qandrew/6.115-final-project/Lab Notebook/Pics/5-4d.jpg

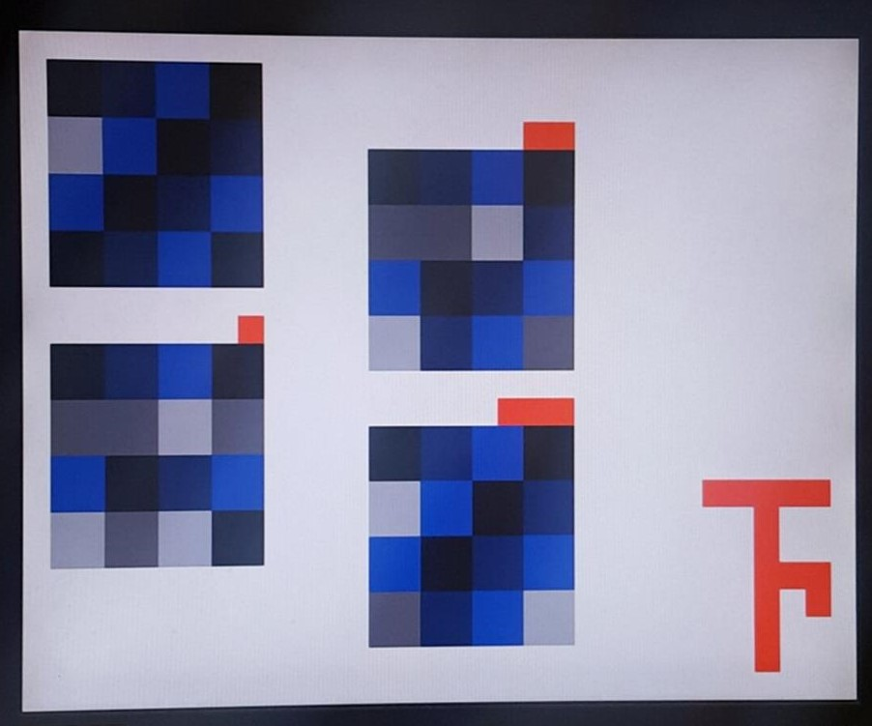
Lab Notebook/Pics/5-4d.jpg
