qandrew/6.115-final-project/Code/VGA/Tic Tac Toe.cydsn/ComponentUpdateLog.txt

Last Modified Date & Time: 04/25/2016 21:32:52

RS232: TopDesign.cysch
	LCD [v1.70] to [v2.20]
	UART [v2.20] to [v2.50]
	RX [v1.70] to [v2.20]
	TX [v1.70] to [v2.20]
	rx_int [v1.60] to [v1.70]
	tx_int [v1.60] to [v1.70]

RS232: RS232.cydwr
	cy_boot [v3.20] to [v5.30]
