qandrew/6.115-final-project/Code/VGA/Tic Tac Toe.cydsn/codegentemp/Pin3.h

/*******************************************************************************
* File Name: Pin3.h  
* Version 2.20
*
* Description:
*  This file contains Pin function prototypes and register defines
*
* Note:
*
********************************************************************************
* Copyright 2008-2015, Cypress Semiconductor Corporation.  All rights reserved.
* You may use this file only in accordance with the license, terms, conditions, 
* disclaimers, and limitations in the end user license agreement accompanying 
* the software package with which this file was provided.
*******************************************************************************/

#if !defined(CY_PINS_Pin3_H) /* Pins Pin3_H */
#define CY_PINS_Pin3_H

#include "cytypes.h"
#include "cyfitter.h"
#include "cypins.h"
#include "Pin3_aliases.h"

/* APIs are not generated for P15[7:6] */
#if !(CY_PSOC5A &&\
	 Pin3__PORT == 15 && ((Pin3__MASK & 0xC0) != 0))


/***************************************
*        Function Prototypes             
***************************************/    

/**
* \addtogroup group_general
* @{
*/
void    Pin3_Write(uint8 value);
void    Pin3_SetDriveMode(uint8 mode);
uint8   Pin3_ReadDataReg(void);
uint8   Pin3_Read(void);
void    Pin3_SetInterruptMode(uint16 position, uint16 mode);
uint8   Pin3_ClearInterrupt(void);
/** @} general */

/***************************************
*           API Constants        
***************************************/
/**
* \addtogroup group_constants
* @{
*/
    /** \addtogroup driveMode Drive mode constants
     * \brief Constants to be passed as "mode" parameter in the Pin3_SetDriveMode() function.
     *  @{
     */
        #define Pin3_DM_ALG_HIZ         PIN_DM_ALG_HIZ
        #define Pin3_DM_DIG_HIZ         PIN_DM_DIG_HIZ
        #define Pin3_DM_RES_UP          PIN_DM_RES_UP
        #define Pin3_DM_RES_DWN         PIN_DM_RES_DWN
        #define Pin3_DM_OD_LO           PIN_DM_OD_LO
        #define Pin3_DM_OD_HI           PIN_DM_OD_HI
        #define Pin3_DM_STRONG          PIN_DM_STRONG
        #define Pin3_DM_RES_UPDWN       PIN_DM_RES_UPDWN
    /** @} driveMode */
/** @} group_constants */
    
/* Digital Port Constants */
#define Pin3_MASK               Pin3__MASK
#define Pin3_SHIFT              Pin3__SHIFT
#define Pin3_WIDTH              8u

/* Interrupt constants */
#if defined(Pin3__INTSTAT)
/**
* \addtogroup group_constants
* @{
*/
    /** \addtogroup intrMode Interrupt constants
     * \brief Constants to be passed as "mode" parameter in Pin3_SetInterruptMode() function.
     *  @{
     */
        #define Pin3_INTR_NONE      (uint16)(0x0000u)
        #define Pin3_INTR_RISING    (uint16)(0x0001u)
        #define Pin3_INTR_FALLING   (uint16)(0x0002u)
        #define Pin3_INTR_BOTH      (uint16)(0x0003u) 
    /** @} intrMode */
/** @} group_constants */

    #define Pin3_INTR_MASK      (0x01u) 
#endif /* (Pin3__INTSTAT) */


/***************************************
*             Registers        
***************************************/

/* Main Port Registers */
/* Pin State */
#define Pin3_PS                     (* (reg8 *) Pin3__PS)
/* Data Register */
#define Pin3_DR                     (* (reg8 *) Pin3__DR)
/* Port Number */
#define Pin3_PRT_NUM                (* (reg8 *) Pin3__PRT) 
/* Connect to Analog Globals */                                                  
#define Pin3_AG                     (* (reg8 *) Pin3__AG)                       
/* Analog MUX bux enable */
#define Pin3_AMUX                   (* (reg8 *) Pin3__AMUX) 
/* Bidirectional Enable */                                                        
#define Pin3_BIE                    (* (reg8 *) Pin3__BIE)
/* Bit-mask for Aliased Register Access */
#define Pin3_BIT_MASK               (* (reg8 *) Pin3__BIT_MASK)
/* Bypass Enable */
#define Pin3_BYP                    (* (reg8 *) Pin3__BYP)
/* Port wide control signals */                                                   
#define Pin3_CTL                    (* (reg8 *) Pin3__CTL)
/* Drive Modes */
#define Pin3_DM0                    (* (reg8 *) Pin3__DM0) 
#define Pin3_DM1                    (* (reg8 *) Pin3__DM1)
#define Pin3_DM2                    (* (reg8 *) Pin3__DM2) 
/* Input Buffer Disable Override */
#define Pin3_INP_DIS                (* (reg8 *) Pin3__INP_DIS)
/* LCD Common or Segment Drive */
#define Pin3_LCD_COM_SEG            (* (reg8 *) Pin3__LCD_COM_SEG)
/* Enable Segment LCD */
#define Pin3_LCD_EN                 (* (reg8 *) Pin3__LCD_EN)
/* Slew Rate Control */
#define Pin3_SLW                    (* (reg8 *) Pin3__SLW)

/* DSI Port Registers */
/* Global DSI Select Register */
#define Pin3_PRTDSI__CAPS_SEL       (* (reg8 *) Pin3__PRTDSI__CAPS_SEL) 
/* Double Sync Enable */
#define Pin3_PRTDSI__DBL_SYNC_IN    (* (reg8 *) Pin3__PRTDSI__DBL_SYNC_IN) 
/* Output Enable Select Drive Strength */
#define Pin3_PRTDSI__OE_SEL0        (* (reg8 *) Pin3__PRTDSI__OE_SEL0) 
#define Pin3_PRTDSI__OE_SEL1        (* (reg8 *) Pin3__PRTDSI__OE_SEL1) 
/* Port Pin Output Select Registers */
#define Pin3_PRTDSI__OUT_SEL0       (* (reg8 *) Pin3__PRTDSI__OUT_SEL0) 
#define Pin3_PRTDSI__OUT_SEL1       (* (reg8 *) Pin3__PRTDSI__OUT_SEL1) 
/* Sync Output Enable Registers */
#define Pin3_PRTDSI__SYNC_OUT       (* (reg8 *) Pin3__PRTDSI__SYNC_OUT) 

/* SIO registers */
#if defined(Pin3__SIO_CFG)
    #define Pin3_SIO_HYST_EN        (* (reg8 *) Pin3__SIO_HYST_EN)
    #define Pin3_SIO_REG_HIFREQ     (* (reg8 *) Pin3__SIO_REG_HIFREQ)
    #define Pin3_SIO_CFG            (* (reg8 *) Pin3__SIO_CFG)
    #define Pin3_SIO_DIFF           (* (reg8 *) Pin3__SIO_DIFF)
#endif /* (Pin3__SIO_CFG) */

/* Interrupt Registers */
#if defined(Pin3__INTSTAT)
    #define Pin3_INTSTAT            (* (reg8 *) Pin3__INTSTAT)
    #define Pin3_SNAP               (* (reg8 *) Pin3__SNAP)
    
	#define Pin3_0_INTTYPE_REG 		(* (reg8 *) Pin3__0__INTTYPE)
	#define Pin3_1_INTTYPE_REG 		(* (reg8 *) Pin3__1__INTTYPE)
	#define Pin3_2_INTTYPE_REG 		(* (reg8 *) Pin3__2__INTTYPE)
	#define Pin3_3_INTTYPE_REG 		(* (reg8 *) Pin3__3__INTTYPE)
	#define Pin3_4_INTTYPE_REG 		(* (reg8 *) Pin3__4__INTTYPE)
	#define Pin3_5_INTTYPE_REG 		(* (reg8 *) Pin3__5__INTTYPE)
	#define Pin3_6_INTTYPE_REG 		(* (reg8 *) Pin3__6__INTTYPE)
	#define Pin3_7_INTTYPE_REG 		(* (reg8 *) Pin3__7__INTTYPE)
#endif /* (Pin3__INTSTAT) */

#endif /* CY_PSOC5A... */

#endif /*  CY_PINS_Pin3_H */


/* [] END OF FILE */
