qandrew/6.115-final-project/Code/VGA/Tic Tac Toe.cydsn/codegentemp/cyfitter.h

#ifndef INCLUDED_CYFITTER_H
#define INCLUDED_CYFITTER_H
#include "cydevice.h"
#include "cydevice_trm.h"

/* RX */
#define RX__0__INTTYPE CYREG_PICU6_INTTYPE0
#define RX__0__MASK 0x01u
#define RX__0__PC CYREG_PRT6_PC0
#define RX__0__PORT 6u
#define RX__0__SHIFT 0
#define RX__AG CYREG_PRT6_AG
#define RX__AMUX CYREG_PRT6_AMUX
#define RX__BIE CYREG_PRT6_BIE
#define RX__BIT_MASK CYREG_PRT6_BIT_MASK
#define RX__BYP CYREG_PRT6_BYP
#define RX__CTL CYREG_PRT6_CTL
#define RX__DM0 CYREG_PRT6_DM0
#define RX__DM1 CYREG_PRT6_DM1
#define RX__DM2 CYREG_PRT6_DM2
#define RX__DR CYREG_PRT6_DR
#define RX__INP_DIS CYREG_PRT6_INP_DIS
#define RX__INTTYPE_BASE CYDEV_PICU_INTTYPE_PICU6_BASE
#define RX__LCD_COM_SEG CYREG_PRT6_LCD_COM_SEG
#define RX__LCD_EN CYREG_PRT6_LCD_EN
#define RX__MASK 0x01u
#define RX__PORT 6u
#define RX__PRT CYREG_PRT6_PRT
#define RX__PRTDSI__CAPS_SEL CYREG_PRT6_CAPS_SEL
#define RX__PRTDSI__DBL_SYNC_IN CYREG_PRT6_DBL_SYNC_IN
#define RX__PRTDSI__OE_SEL0 CYREG_PRT6_OE_SEL0
#define RX__PRTDSI__OE_SEL1 CYREG_PRT6_OE_SEL1
#define RX__PRTDSI__OUT_SEL0 CYREG_PRT6_OUT_SEL0
#define RX__PRTDSI__OUT_SEL1 CYREG_PRT6_OUT_SEL1
#define RX__PRTDSI__SYNC_OUT CYREG_PRT6_SYNC_OUT
#define RX__PS CYREG_PRT6_PS
#define RX__SHIFT 0
#define RX__SLW CYREG_PRT6_SLW

/* TX */
#define TX__0__INTTYPE CYREG_PICU12_INTTYPE6
#define TX__0__MASK 0x40u
#define TX__0__PC CYREG_PRT12_PC6
#define TX__0__PORT 12u
#define TX__0__SHIFT 6
#define TX__AG CYREG_PRT12_AG
#define TX__BIE CYREG_PRT12_BIE
#define TX__BIT_MASK CYREG_PRT12_BIT_MASK
#define TX__BYP CYREG_PRT12_BYP
#define TX__DM0 CYREG_PRT12_DM0
#define TX__DM1 CYREG_PRT12_DM1
#define TX__DM2 CYREG_PRT12_DM2
#define TX__DR CYREG_PRT12_DR
#define TX__INP_DIS CYREG_PRT12_INP_DIS
#define TX__INTTYPE_BASE CYDEV_PICU_INTTYPE_PICU12_BASE
#define TX__MASK 0x40u
#define TX__PORT 12u
#define TX__PRT CYREG_PRT12_PRT
#define TX__PRTDSI__DBL_SYNC_IN CYREG_PRT12_DBL_SYNC_IN
#define TX__PRTDSI__OE_SEL0 CYREG_PRT12_OE_SEL0
#define TX__PRTDSI__OE_SEL1 CYREG_PRT12_OE_SEL1
#define TX__PRTDSI__OUT_SEL0 CYREG_PRT12_OUT_SEL0
#define TX__PRTDSI__OUT_SEL1 CYREG_PRT12_OUT_SEL1
#define TX__PRTDSI__SYNC_OUT CYREG_PRT12_SYNC_OUT
#define TX__PS CYREG_PRT12_PS
#define TX__SHIFT 6
#define TX__SIO_CFG CYREG_PRT12_SIO_CFG
#define TX__SIO_DIFF CYREG_PRT12_SIO_DIFF
#define TX__SIO_HYST_EN CYREG_PRT12_SIO_HYST_EN
#define TX__SIO_REG_HIFREQ CYREG_PRT12_SIO_REG_HIFREQ
#define TX__SLW CYREG_PRT12_SLW

/* LCD_LCDPort */
#define LCD_LCDPort__0__INTTYPE CYREG_PICU2_INTTYPE0
#define LCD_LCDPort__0__MASK 0x01u
#define LCD_LCDPort__0__PC CYREG_PRT2_PC0
#define LCD_LCDPort__0__PORT 2u
#define LCD_LCDPort__0__SHIFT 0
#define LCD_LCDPort__1__INTTYPE CYREG_PICU2_INTTYPE1
#define LCD_LCDPort__1__MASK 0x02u
#define LCD_LCDPort__1__PC CYREG_PRT2_PC1
#define LCD_LCDPort__1__PORT 2u
#define LCD_LCDPort__1__SHIFT 1
#define LCD_LCDPort__2__INTTYPE CYREG_PICU2_INTTYPE2
#define LCD_LCDPort__2__MASK 0x04u
#define LCD_LCDPort__2__PC CYREG_PRT2_PC2
#define LCD_LCDPort__2__PORT 2u
#define LCD_LCDPort__2__SHIFT 2
#define LCD_LCDPort__3__INTTYPE CYREG_PICU2_INTTYPE3
#define LCD_LCDPort__3__MASK 0x08u
#define LCD_LCDPort__3__PC CYREG_PRT2_PC3
#define LCD_LCDPort__3__PORT 2u
#define LCD_LCDPort__3__SHIFT 3
#define LCD_LCDPort__4__INTTYPE CYREG_PICU2_INTTYPE4
#define LCD_LCDPort__4__MASK 0x10u
#define LCD_LCDPort__4__PC CYREG_PRT2_PC4
#define LCD_LCDPort__4__PORT 2u
#define LCD_LCDPort__4__SHIFT 4
#define LCD_LCDPort__5__INTTYPE CYREG_PICU2_INTTYPE5
#define LCD_LCDPort__5__MASK 0x20u
#define LCD_LCDPort__5__PC CYREG_PRT2_PC5
#define LCD_LCDPort__5__PORT 2u
#define LCD_LCDPort__5__SHIFT 5
#define LCD_LCDPort__6__INTTYPE CYREG_PICU2_INTTYPE6
#define LCD_LCDPort__6__MASK 0x40u
#define LCD_LCDPort__6__PC CYREG_PRT2_PC6
#define LCD_LCDPort__6__PORT 2u
#define LCD_LCDPort__6__SHIFT 6
#define LCD_LCDPort__AG CYREG_PRT2_AG
#define LCD_LCDPort__AMUX CYREG_PRT2_AMUX
#define LCD_LCDPort__BIE CYREG_PRT2_BIE
#define LCD_LCDPort__BIT_MASK CYREG_PRT2_BIT_MASK
#define LCD_LCDPort__BYP CYREG_PRT2_BYP
#define LCD_LCDPort__CTL CYREG_PRT2_CTL
#define LCD_LCDPort__DM0 CYREG_PRT2_DM0
#define LCD_LCDPort__DM1 CYREG_PRT2_DM1
#define LCD_LCDPort__DM2 CYREG_PRT2_DM2
#define LCD_LCDPort__DR CYREG_PRT2_DR
#define LCD_LCDPort__INP_DIS CYREG_PRT2_INP_DIS
#define LCD_LCDPort__INTTYPE_BASE CYDEV_PICU_INTTYPE_PICU2_BASE
#define LCD_LCDPort__LCD_COM_SEG CYREG_PRT2_LCD_COM_SEG
#define LCD_LCDPort__LCD_EN CYREG_PRT2_LCD_EN
#define LCD_LCDPort__MASK 0x7Fu
#define LCD_LCDPort__PORT 2u
#define LCD_LCDPort__PRT CYREG_PRT2_PRT
#define LCD_LCDPort__PRTDSI__CAPS_SEL CYREG_PRT2_CAPS_SEL
#define LCD_LCDPort__PRTDSI__DBL_SYNC_IN CYREG_PRT2_DBL_SYNC_IN
#define LCD_LCDPort__PRTDSI__OE_SEL0 CYREG_PRT2_OE_SEL0
#define LCD_LCDPort__PRTDSI__OE_SEL1 CYREG_PRT2_OE_SEL1
#define LCD_LCDPort__PRTDSI__OUT_SEL0 CYREG_PRT2_OUT_SEL0
#define LCD_LCDPort__PRTDSI__OUT_SEL1 CYREG_PRT2_OUT_SEL1
#define LCD_LCDPort__PRTDSI__SYNC_OUT CYREG_PRT2_SYNC_OUT
#define LCD_LCDPort__PS CYREG_PRT2_PS
#define LCD_LCDPort__SHIFT 0
#define LCD_LCDPort__SLW CYREG_PRT2_SLW

/* Pin0 */
#define Pin0__0__INTTYPE CYREG_PICU0_INTTYPE0
#define Pin0__0__MASK 0x01u
#define Pin0__0__PC CYREG_PRT0_PC0
#define Pin0__0__PORT 0u
#define Pin0__0__SHIFT 0
#define Pin0__1__INTTYPE CYREG_PICU0_INTTYPE1
#define Pin0__1__MASK 0x02u
#define Pin0__1__PC CYREG_PRT0_PC1
#define Pin0__1__PORT 0u
#define Pin0__1__SHIFT 1
#define Pin0__2__INTTYPE CYREG_PICU0_INTTYPE2
#define Pin0__2__MASK 0x04u
#define Pin0__2__PC CYREG_PRT0_PC2
#define Pin0__2__PORT 0u
#define Pin0__2__SHIFT 2
#define Pin0__3__INTTYPE CYREG_PICU0_INTTYPE3
#define Pin0__3__MASK 0x08u
#define Pin0__3__PC CYREG_PRT0_PC3
#define Pin0__3__PORT 0u
#define Pin0__3__SHIFT 3
#define Pin0__4__INTTYPE CYREG_PICU0_INTTYPE4
#define Pin0__4__MASK 0x10u
#define Pin0__4__PC CYREG_PRT0_PC4
#define Pin0__4__PORT 0u
#define Pin0__4__SHIFT 4
#define Pin0__5__INTTYPE CYREG_PICU0_INTTYPE5
#define Pin0__5__MASK 0x20u
#define Pin0__5__PC CYREG_PRT0_PC5
#define Pin0__5__PORT 0u
#define Pin0__5__SHIFT 5
#define Pin0__AG CYREG_PRT0_AG
#define Pin0__AMUX CYREG_PRT0_AMUX
#define Pin0__BIE CYREG_PRT0_BIE
#define Pin0__BIT_MASK CYREG_PRT0_BIT_MASK
#define Pin0__BYP CYREG_PRT0_BYP
#define Pin0__CTL CYREG_PRT0_CTL
#define Pin0__DM0 CYREG_PRT0_DM0
#define Pin0__DM1 CYREG_PRT0_DM1
#define Pin0__DM2 CYREG_PRT0_DM2
#define Pin0__DR CYREG_PRT0_DR
#define Pin0__INP_DIS CYREG_PRT0_INP_DIS
#define Pin0__INTTYPE_BASE CYDEV_PICU_INTTYPE_PICU0_BASE
#define Pin0__LCD_COM_SEG CYREG_PRT0_LCD_COM_SEG
#define Pin0__LCD_EN CYREG_PRT0_LCD_EN
#define Pin0__MASK 0x3Fu
#define Pin0__PORT 0u
#define Pin0__PRT CYREG_PRT0_PRT
#define Pin0__PRTDSI__CAPS_SEL CYREG_PRT0_CAPS_SEL
#define Pin0__PRTDSI__DBL_SYNC_IN CYREG_PRT0_DBL_SYNC_IN
#define Pin0__PRTDSI__OE_SEL0 CYREG_PRT0_OE_SEL0
#define Pin0__PRTDSI__OE_SEL1 CYREG_PRT0_OE_SEL1
#define Pin0__PRTDSI__OUT_SEL0 CYREG_PRT0_OUT_SEL0
#define Pin0__PRTDSI__OUT_SEL1 CYREG_PRT0_OUT_SEL1
#define Pin0__PRTDSI__SYNC_OUT CYREG_PRT0_SYNC_OUT
#define Pin0__PS CYREG_PRT0_PS
#define Pin0__SHIFT 0
#define Pin0__SLW CYREG_PRT0_SLW

/* Pin3 */
#define Pin3__0__INTTYPE CYREG_PICU3_INTTYPE0
#define Pin3__0__MASK 0x01u
#define Pin3__0__PC CYREG_PRT3_PC0
#define Pin3__0__PORT 3u
#define Pin3__0__SHIFT 0
#define Pin3__1__INTTYPE CYREG_PICU3_INTTYPE1
#define Pin3__1__MASK 0x02u
#define Pin3__1__PC CYREG_PRT3_PC1
#define Pin3__1__PORT 3u
#define Pin3__1__SHIFT 1
#define Pin3__2__INTTYPE CYREG_PICU3_INTTYPE2
#define Pin3__2__MASK 0x04u
#define Pin3__2__PC CYREG_PRT3_PC2
#define Pin3__2__PORT 3u
#define Pin3__2__SHIFT 2
#define Pin3__3__INTTYPE CYREG_PICU3_INTTYPE3
#define Pin3__3__MASK 0x08u
#define Pin3__3__PC CYREG_PRT3_PC3
#define Pin3__3__PORT 3u
#define Pin3__3__SHIFT 3
#define Pin3__4__INTTYPE CYREG_PICU3_INTTYPE4
#define Pin3__4__MASK 0x10u
#define Pin3__4__PC CYREG_PRT3_PC4
#define Pin3__4__PORT 3u
#define Pin3__4__SHIFT 4
#define Pin3__5__INTTYPE CYREG_PICU3_INTTYPE5
#define Pin3__5__MASK 0x20u
#define Pin3__5__PC CYREG_PRT3_PC5
#define Pin3__5__PORT 3u
#define Pin3__5__SHIFT 5
#define Pin3__6__INTTYPE CYREG_PICU3_INTTYPE6
#define Pin3__6__MASK 0x40u
#define Pin3__6__PC CYREG_PRT3_PC6
#define Pin3__6__PORT 3u
#define Pin3__6__SHIFT 6
#define Pin3__7__INTTYPE CYREG_PICU3_INTTYPE7
#define Pin3__7__MASK 0x80u
#define Pin3__7__PC CYREG_PRT3_PC7
#define Pin3__7__PORT 3u
#define Pin3__7__SHIFT 7
#define Pin3__AG CYREG_PRT3_AG
#define Pin3__AMUX CYREG_PRT3_AMUX
#define Pin3__BIE CYREG_PRT3_BIE
#define Pin3__BIT_MASK CYREG_PRT3_BIT_MASK
#define Pin3__BYP CYREG_PRT3_BYP
#define Pin3__CTL CYREG_PRT3_CTL
#define Pin3__DM0 CYREG_PRT3_DM0
#define Pin3__DM1 CYREG_PRT3_DM1
#define Pin3__DM2 CYREG_PRT3_DM2
#define Pin3__DR CYREG_PRT3_DR
#define Pin3__INP_DIS CYREG_PRT3_INP_DIS
#define Pin3__INTTYPE_BASE CYDEV_PICU_INTTYPE_PICU3_BASE
#define Pin3__LCD_COM_SEG CYREG_PRT3_LCD_COM_SEG
#define Pin3__LCD_EN CYREG_PRT3_LCD_EN
#define Pin3__MASK 0xFFu
#define Pin3__PORT 3u
#define Pin3__PRT CYREG_PRT3_PRT
#define Pin3__PRTDSI__CAPS_SEL CYREG_PRT3_CAPS_SEL
#define Pin3__PRTDSI__DBL_SYNC_IN CYREG_PRT3_DBL_SYNC_IN
#define Pin3__PRTDSI__OE_SEL0 CYREG_PRT3_OE_SEL0
#define Pin3__PRTDSI__OE_SEL1 CYREG_PRT3_OE_SEL1
#define Pin3__PRTDSI__OUT_SEL0 CYREG_PRT3_OUT_SEL0
#define Pin3__PRTDSI__OUT_SEL1 CYREG_PRT3_OUT_SEL1
#define Pin3__PRTDSI__SYNC_OUT CYREG_PRT3_SYNC_OUT
#define Pin3__PS CYREG_PRT3_PS
#define Pin3__SHIFT 0
#define Pin3__SLW CYREG_PRT3_SLW

/* UART_BUART */
#define UART_BUART_sRX_RxBitCounter__16BIT_CONTROL_AUX_CTL_REG CYREG_B0_UDB12_13_ACTL
#define UART_BUART_sRX_RxBitCounter__16BIT_CONTROL_CONTROL_REG CYREG_B0_UDB12_13_CTL
#define UART_BUART_sRX_RxBitCounter__16BIT_CONTROL_COUNT_REG CYREG_B0_UDB12_13_CTL
#define UART_BUART_sRX_RxBitCounter__16BIT_COUNT_CONTROL_REG CYREG_B0_UDB12_13_CTL
#define UART_BUART_sRX_RxBitCounter__16BIT_COUNT_COUNT_REG CYREG_B0_UDB12_13_CTL
#define UART_BUART_sRX_RxBitCounter__16BIT_MASK_MASK_REG CYREG_B0_UDB12_13_MSK
#define UART_BUART_sRX_RxBitCounter__16BIT_MASK_PERIOD_REG CYREG_B0_UDB12_13_MSK
#define UART_BUART_sRX_RxBitCounter__16BIT_PERIOD_MASK_REG CYREG_B0_UDB12_13_MSK
#define UART_BUART_sRX_RxBitCounter__16BIT_PERIOD_PERIOD_REG CYREG_B0_UDB12_13_MSK
#define UART_BUART_sRX_RxBitCounter__CONTROL_AUX_CTL_REG CYREG_B0_UDB12_ACTL
#define UART_BUART_sRX_RxBitCounter__CONTROL_REG CYREG_B0_UDB12_CTL
#define UART_BUART_sRX_RxBitCounter__CONTROL_ST_REG CYREG_B0_UDB12_ST_CTL
#define UART_BUART_sRX_RxBitCounter__COUNT_REG CYREG_B0_UDB12_CTL
#define UART_BUART_sRX_RxBitCounter__COUNT_ST_REG CYREG_B0_UDB12_ST_CTL
#define UART_BUART_sRX_RxBitCounter__MASK_CTL_AUX_CTL_REG CYREG_B0_UDB12_MSK_ACTL
#define UART_BUART_sRX_RxBitCounter__PER_CTL_AUX_CTL_REG CYREG_B0_UDB12_MSK_ACTL
#define UART_BUART_sRX_RxBitCounter__PERIOD_REG CYREG_B0_UDB12_MSK
#define UART_BUART_sRX_RxBitCounter_ST__16BIT_STATUS_AUX_CTL_REG CYREG_B0_UDB12_13_ACTL
#define UART_BUART_sRX_RxBitCounter_ST__16BIT_STATUS_REG CYREG_B0_UDB12_13_ST
#define UART_BUART_sRX_RxBitCounter_ST__MASK_REG CYREG_B0_UDB12_MSK
#define UART_BUART_sRX_RxBitCounter_ST__MASK_ST_AUX_CTL_REG CYREG_B0_UDB12_MSK_ACTL
#define UART_BUART_sRX_RxBitCounter_ST__PER_ST_AUX_CTL_REG CYREG_B0_UDB12_MSK_ACTL
#define UART_BUART_sRX_RxBitCounter_ST__STATUS_AUX_CTL_REG CYREG_B0_UDB12_ACTL
#define UART_BUART_sRX_RxBitCounter_ST__STATUS_CNT_REG CYREG_B0_UDB12_ST_CTL
#define UART_BUART_sRX_RxBitCounter_ST__STATUS_CONTROL_REG CYREG_B0_UDB12_ST_CTL
#define UART_BUART_sRX_RxBitCounter_ST__STATUS_REG CYREG_B0_UDB12_ST
#define UART_BUART_sRX_RxShifter_u0__16BIT_A0_REG CYREG_B0_UDB12_13_A0
#define UART_BUART_sRX_RxShifter_u0__16BIT_A1_REG CYREG_B0_UDB12_13_A1
#define UART_BUART_sRX_RxShifter_u0__16BIT_D0_REG CYREG_B0_UDB12_13_D0
#define UART_BUART_sRX_RxShifter_u0__16BIT_D1_REG CYREG_B0_UDB12_13_D1
#define UART_BUART_sRX_RxShifter_u0__16BIT_DP_AUX_CTL_REG CYREG_B0_UDB12_13_ACTL
#define UART_BUART_sRX_RxShifter_u0__16BIT_F0_REG CYREG_B0_UDB12_13_F0
#define UART_BUART_sRX_RxShifter_u0__16BIT_F1_REG CYREG_B0_UDB12_13_F1
#define UART_BUART_sRX_RxShifter_u0__A0_A1_REG CYREG_B0_UDB12_A0_A1
#define UART_BUART_sRX_RxShifter_u0__A0_REG CYREG_B0_UDB12_A0
#define UART_BUART_sRX_RxShifter_u0__A1_REG CYREG_B0_UDB12_A1
#define UART_BUART_sRX_RxShifter_u0__D0_D1_REG CYREG_B0_UDB12_D0_D1
#define UART_BUART_sRX_RxShifter_u0__D0_REG CYREG_B0_UDB12_D0
#define UART_BUART_sRX_RxShifter_u0__D1_REG CYREG_B0_UDB12_D1
#define UART_BUART_sRX_RxShifter_u0__DP_AUX_CTL_REG CYREG_B0_UDB12_ACTL
#define UART_BUART_sRX_RxShifter_u0__F0_F1_REG CYREG_B0_UDB12_F0_F1
#define UART_BUART_sRX_RxShifter_u0__F0_REG CYREG_B0_UDB12_F0
#define UART_BUART_sRX_RxShifter_u0__F1_REG CYREG_B0_UDB12_F1
#define UART_BUART_sRX_RxShifter_u0__MSK_DP_AUX_CTL_REG CYREG_B0_UDB12_MSK_ACTL
#define UART_BUART_sRX_RxShifter_u0__PER_DP_AUX_CTL_REG CYREG_B0_UDB12_MSK_ACTL
#define UART_BUART_sRX_RxSts__16BIT_STATUS_AUX_CTL_REG CYREG_B0_UDB13_14_ACTL
#define UART_BUART_sRX_RxSts__16BIT_STATUS_REG CYREG_B0_UDB13_14_ST
#define UART_BUART_sRX_RxSts__3__MASK 0x08u
#define UART_BUART_sRX_RxSts__3__POS 3
#define UART_BUART_sRX_RxSts__4__MASK 0x10u
#define UART_BUART_sRX_RxSts__4__POS 4
#define UART_BUART_sRX_RxSts__5__MASK 0x20u
#define UART_BUART_sRX_RxSts__5__POS 5
#define UART_BUART_sRX_RxSts__MASK 0x38u
#define UART_BUART_sRX_RxSts__MASK_REG CYREG_B0_UDB13_MSK
#define UART_BUART_sRX_RxSts__STATUS_AUX_CTL_REG CYREG_B0_UDB13_ACTL
#define UART_BUART_sRX_RxSts__STATUS_REG CYREG_B0_UDB13_ST
#define UART_BUART_sTX_sCLOCK_TxBitClkGen__16BIT_A0_REG CYREG_B0_UDB10_11_A0
#define UART_BUART_sTX_sCLOCK_TxBitClkGen__16BIT_A1_REG CYREG_B0_UDB10_11_A1
#define UART_BUART_sTX_sCLOCK_TxBitClkGen__16BIT_D0_REG CYREG_B0_UDB10_11_D0
#define UART_BUART_sTX_sCLOCK_TxBitClkGen__16BIT_D1_REG CYREG_B0_UDB10_11_D1
#define UART_BUART_sTX_sCLOCK_TxBitClkGen__16BIT_DP_AUX_CTL_REG CYREG_B0_UDB10_11_ACTL
#define UART_BUART_sTX_sCLOCK_TxBitClkGen__16BIT_F0_REG CYREG_B0_UDB10_11_F0
#define UART_BUART_sTX_sCLOCK_TxBitClkGen__16BIT_F1_REG CYREG_B0_UDB10_11_F1
#define UART_BUART_sTX_sCLOCK_TxBitClkGen__A0_A1_REG CYREG_B0_UDB10_A0_A1
#define UART_BUART_sTX_sCLOCK_TxBitClkGen__A0_REG CYREG_B0_UDB10_A0
#define UART_BUART_sTX_sCLOCK_TxBitClkGen__A1_REG CYREG_B0_UDB10_A1
#define UART_BUART_sTX_sCLOCK_TxBitClkGen__D0_D1_REG CYREG_B0_UDB10_D0_D1
#define UART_BUART_sTX_sCLOCK_TxBitClkGen__D0_REG CYREG_B0_UDB10_D0
#define UART_BUART_sTX_sCLOCK_TxBitClkGen__D1_REG CYREG_B0_UDB10_D1
#define UART_BUART_sTX_sCLOCK_TxBitClkGen__DP_AUX_CTL_REG CYREG_B0_UDB10_ACTL
#define UART_BUART_sTX_sCLOCK_TxBitClkGen__F0_F1_REG CYREG_B0_UDB10_F0_F1
#define UART_BUART_sTX_sCLOCK_TxBitClkGen__F0_REG CYREG_B0_UDB10_F0
#define UART_BUART_sTX_sCLOCK_TxBitClkGen__F1_REG CYREG_B0_UDB10_F1
#define UART_BUART_sTX_TxShifter_u0__16BIT_A0_REG CYREG_B0_UDB11_12_A0
#define UART_BUART_sTX_TxShifter_u0__16BIT_A1_REG CYREG_B0_UDB11_12_A1
#define UART_BUART_sTX_TxShifter_u0__16BIT_D0_REG CYREG_B0_UDB11_12_D0
#define UART_BUART_sTX_TxShifter_u0__16BIT_D1_REG CYREG_B0_UDB11_12_D1
#define UART_BUART_sTX_TxShifter_u0__16BIT_DP_AUX_CTL_REG CYREG_B0_UDB11_12_ACTL
#define UART_BUART_sTX_TxShifter_u0__16BIT_F0_REG CYREG_B0_UDB11_12_F0
#define UART_BUART_sTX_TxShifter_u0__16BIT_F1_REG CYREG_B0_UDB11_12_F1
#define UART_BUART_sTX_TxShifter_u0__A0_A1_REG CYREG_B0_UDB11_A0_A1
#define UART_BUART_sTX_TxShifter_u0__A0_REG CYREG_B0_UDB11_A0
#define UART_BUART_sTX_TxShifter_u0__A1_REG CYREG_B0_UDB11_A1
#define UART_BUART_sTX_TxShifter_u0__D0_D1_REG CYREG_B0_UDB11_D0_D1
#define UART_BUART_sTX_TxShifter_u0__D0_REG CYREG_B0_UDB11_D0
#define UART_BUART_sTX_TxShifter_u0__D1_REG CYREG_B0_UDB11_D1
#define UART_BUART_sTX_TxShifter_u0__DP_AUX_CTL_REG CYREG_B0_UDB11_ACTL
#define UART_BUART_sTX_TxShifter_u0__F0_F1_REG CYREG_B0_UDB11_F0_F1
#define UART_BUART_sTX_TxShifter_u0__F0_REG CYREG_B0_UDB11_F0
#define UART_BUART_sTX_TxShifter_u0__F1_REG CYREG_B0_UDB11_F1
#define UART_BUART_sTX_TxSts__0__MASK 0x01u
#define UART_BUART_sTX_TxSts__0__POS 0
#define UART_BUART_sTX_TxSts__1__MASK 0x02u
#define UART_BUART_sTX_TxSts__1__POS 1
#define UART_BUART_sTX_TxSts__16BIT_STATUS_AUX_CTL_REG CYREG_B0_UDB10_11_ACTL
#define UART_BUART_sTX_TxSts__16BIT_STATUS_REG CYREG_B0_UDB10_11_ST
#define UART_BUART_sTX_TxSts__2__MASK 0x04u
#define UART_BUART_sTX_TxSts__2__POS 2
#define UART_BUART_sTX_TxSts__3__MASK 0x08u
#define UART_BUART_sTX_TxSts__3__POS 3
#define UART_BUART_sTX_TxSts__MASK 0x0Fu
#define UART_BUART_sTX_TxSts__MASK_REG CYREG_B0_UDB10_MSK
#define UART_BUART_sTX_TxSts__STATUS_AUX_CTL_REG CYREG_B0_UDB10_ACTL
#define UART_BUART_sTX_TxSts__STATUS_REG CYREG_B0_UDB10_ST

/* UART_IntClock */
#define UART_IntClock__CFG0 CYREG_CLKDIST_DCFG1_CFG0
#define UART_IntClock__CFG1 CYREG_CLKDIST_DCFG1_CFG1
#define UART_IntClock__CFG2 CYREG_CLKDIST_DCFG1_CFG2
#define UART_IntClock__CFG2_SRC_SEL_MASK 0x07u
#define UART_IntClock__INDEX 0x01u
#define UART_IntClock__PM_ACT_CFG CYREG_PM_ACT_CFG2
#define UART_IntClock__PM_ACT_MSK 0x02u
#define UART_IntClock__PM_STBY_CFG CYREG_PM_STBY_CFG2
#define UART_IntClock__PM_STBY_MSK 0x02u

/* Zhong */
#define Zhong__CFG0 CYREG_CLKDIST_DCFG0_CFG0
#define Zhong__CFG1 CYREG_CLKDIST_DCFG0_CFG1
#define Zhong__CFG2 CYREG_CLKDIST_DCFG0_CFG2
#define Zhong__CFG2_SRC_SEL_MASK 0x07u
#define Zhong__INDEX 0x00u
#define Zhong__PM_ACT_CFG CYREG_PM_ACT_CFG2
#define Zhong__PM_ACT_MSK 0x01u
#define Zhong__PM_STBY_CFG CYREG_PM_STBY_CFG2
#define Zhong__PM_STBY_MSK 0x01u

/* rx_int */
#define rx_int__INTC_CLR_EN_REG CYREG_NVIC_CLRENA0
#define rx_int__INTC_CLR_PD_REG CYREG_NVIC_CLRPEND0
#define rx_int__INTC_MASK 0x01u
#define rx_int__INTC_NUMBER 0u
#define rx_int__INTC_PRIOR_NUM 7u
#define rx_int__INTC_PRIOR_REG CYREG_NVIC_PRI_0
#define rx_int__INTC_SET_EN_REG CYREG_NVIC_SETENA0
#define rx_int__INTC_SET_PD_REG CYREG_NVIC_SETPEND0

/* tx_int */
#define tx_int__INTC_CLR_EN_REG CYREG_NVIC_CLRENA0
#define tx_int__INTC_CLR_PD_REG CYREG_NVIC_CLRPEND0
#define tx_int__INTC_MASK 0x02u
#define tx_int__INTC_NUMBER 1u
#define tx_int__INTC_PRIOR_NUM 7u
#define tx_int__INTC_PRIOR_REG CYREG_NVIC_PRI_1
#define tx_int__INTC_SET_EN_REG CYREG_NVIC_SETENA0
#define tx_int__INTC_SET_PD_REG CYREG_NVIC_SETPEND0

/* PinNoise */
#define PinNoise__0__INTTYPE CYREG_PICU6_INTTYPE6
#define PinNoise__0__MASK 0x40u
#define PinNoise__0__PC CYREG_PRT6_PC6
#define PinNoise__0__PORT 6u
#define PinNoise__0__SHIFT 6
#define PinNoise__AG CYREG_PRT6_AG
#define PinNoise__AMUX CYREG_PRT6_AMUX
#define PinNoise__BIE CYREG_PRT6_BIE
#define PinNoise__BIT_MASK CYREG_PRT6_BIT_MASK
#define PinNoise__BYP CYREG_PRT6_BYP
#define PinNoise__CTL CYREG_PRT6_CTL
#define PinNoise__DM0 CYREG_PRT6_DM0
#define PinNoise__DM1 CYREG_PRT6_DM1
#define PinNoise__DM2 CYREG_PRT6_DM2
#define PinNoise__DR CYREG_PRT6_DR
#define PinNoise__INP_DIS CYREG_PRT6_INP_DIS
#define PinNoise__INTTYPE_BASE CYDEV_PICU_INTTYPE_PICU6_BASE
#define PinNoise__LCD_COM_SEG CYREG_PRT6_LCD_COM_SEG
#define PinNoise__LCD_EN CYREG_PRT6_LCD_EN
#define PinNoise__MASK 0x40u
#define PinNoise__PORT 6u
#define PinNoise__PRT CYREG_PRT6_PRT
#define PinNoise__PRTDSI__CAPS_SEL CYREG_PRT6_CAPS_SEL
#define PinNoise__PRTDSI__DBL_SYNC_IN CYREG_PRT6_DBL_SYNC_IN
#define PinNoise__PRTDSI__OE_SEL0 CYREG_PRT6_OE_SEL0
#define PinNoise__PRTDSI__OE_SEL1 CYREG_PRT6_OE_SEL1
#define PinNoise__PRTDSI__OUT_SEL0 CYREG_PRT6_OUT_SEL0
#define PinNoise__PRTDSI__OUT_SEL1 CYREG_PRT6_OUT_SEL1
#define PinNoise__PRTDSI__SYNC_OUT CYREG_PRT6_SYNC_OUT
#define PinNoise__PS CYREG_PRT6_PS
#define PinNoise__SHIFT 6
#define PinNoise__SLW CYREG_PRT6_SLW

/* Miscellaneous */
#define BCLK__BUS_CLK__HZ 24000000U
#define BCLK__BUS_CLK__KHZ 24000U
#define BCLK__BUS_CLK__MHZ 24U
#define CY_PROJECT_NAME "Tic Tac Toe"
#define CY_VERSION "PSoC Creator  3.3 CP2"
#define CYDEV_CHIP_DIE_LEOPARD 1u
#define CYDEV_CHIP_DIE_PANTHER 18u
#define CYDEV_CHIP_DIE_PSOC4A 10u
#define CYDEV_CHIP_DIE_PSOC5LP 17u
#define CYDEV_CHIP_DIE_TMA4 2u
#define CYDEV_CHIP_DIE_UNKNOWN 0u
#define CYDEV_CHIP_FAMILY_PSOC3 1u
#define CYDEV_CHIP_FAMILY_PSOC4 2u
#define CYDEV_CHIP_FAMILY_PSOC5 3u
#define CYDEV_CHIP_FAMILY_UNKNOWN 0u
#define CYDEV_CHIP_FAMILY_USED CYDEV_CHIP_FAMILY_PSOC5
#define CYDEV_CHIP_JTAG_ID 0x2E123069u
#define CYDEV_CHIP_MEMBER_3A 1u
#define CYDEV_CHIP_MEMBER_4A 10u
#define CYDEV_CHIP_MEMBER_4C 15u
#define CYDEV_CHIP_MEMBER_4D 6u
#define CYDEV_CHIP_MEMBER_4E 4u
#define CYDEV_CHIP_MEMBER_4F 11u
#define CYDEV_CHIP_MEMBER_4G 2u
#define CYDEV_CHIP_MEMBER_4H 9u
#define CYDEV_CHIP_MEMBER_4I 14u
#define CYDEV_CHIP_MEMBER_4J 7u
#define CYDEV_CHIP_MEMBER_4K 8u
#define CYDEV_CHIP_MEMBER_4L 13u
#define CYDEV_CHIP_MEMBER_4M 12u
#define CYDEV_CHIP_MEMBER_4N 5u
#define CYDEV_CHIP_MEMBER_4U 3u
#define CYDEV_CHIP_MEMBER_5A 17u
#define CYDEV_CHIP_MEMBER_5B 16u
#define CYDEV_CHIP_MEMBER_UNKNOWN 0u
#define CYDEV_CHIP_MEMBER_USED CYDEV_CHIP_MEMBER_5B
#define CYDEV_CHIP_DIE_EXPECT CYDEV_CHIP_MEMBER_USED
#define CYDEV_CHIP_DIE_ACTUAL CYDEV_CHIP_DIE_EXPECT
#define CYDEV_CHIP_REV_LEOPARD_ES1 0u
#define CYDEV_CHIP_REV_LEOPARD_ES2 1u
#define CYDEV_CHIP_REV_LEOPARD_ES3 3u
#define CYDEV_CHIP_REV_LEOPARD_PRODUCTION 3u
#define CYDEV_CHIP_REV_PANTHER_ES0 0u
#define CYDEV_CHIP_REV_PANTHER_ES1 1u
#define CYDEV_CHIP_REV_PANTHER_PRODUCTION 1u
#define CYDEV_CHIP_REV_PSOC4A_ES0 17u
#define CYDEV_CHIP_REV_PSOC4A_PRODUCTION 17u
#define CYDEV_CHIP_REV_PSOC5LP_ES0 0u
#define CYDEV_CHIP_REV_PSOC5LP_PRODUCTION 0u
#define CYDEV_CHIP_REV_TMA4_ES 17u
#define CYDEV_CHIP_REV_TMA4_ES2 33u
#define CYDEV_CHIP_REV_TMA4_PRODUCTION 17u
#define CYDEV_CHIP_REVISION_3A_ES1 0u
#define CYDEV_CHIP_REVISION_3A_ES2 1u
#define CYDEV_CHIP_REVISION_3A_ES3 3u
#define CYDEV_CHIP_REVISION_3A_PRODUCTION 3u
#define CYDEV_CHIP_REVISION_4A_ES0 17u
#define CYDEV_CHIP_REVISION_4A_PRODUCTION 17u
#define CYDEV_CHIP_REVISION_4C_PRODUCTION 0u
#define CYDEV_CHIP_REVISION_4D_PRODUCTION 0u
#define CYDEV_CHIP_REVISION_4E_PRODUCTION 0u
#define CYDEV_CHIP_REVISION_4F_PRODUCTION 0u
#define CYDEV_CHIP_REVISION_4F_PRODUCTION_256DMA 0u
#define CYDEV_CHIP_REVISION_4F_PRODUCTION_256K 0u
#define CYDEV_CHIP_REVISION_4G_ES 17u
#define CYDEV_CHIP_REVISION_4G_ES2 33u
#define CYDEV_CHIP_REVISION_4G_PRODUCTION 17u
#define CYDEV_CHIP_REVISION_4H_PRODUCTION 0u
#define CYDEV_CHIP_REVISION_4I_PRODUCTION 0u
#define CYDEV_CHIP_REVISION_4J_PRODUCTION 0u
#define CYDEV_CHIP_REVISION_4K_PRODUCTION 0u
#define CYDEV_CHIP_REVISION_4L_PRODUCTION 0u
#define CYDEV_CHIP_REVISION_4M_PRODUCTION 0u
#define CYDEV_CHIP_REVISION_4N_PRODUCTION 0u
#define CYDEV_CHIP_REVISION_4U_PRODUCTION 0u
#define CYDEV_CHIP_REVISION_5A_ES0 0u
#define CYDEV_CHIP_REVISION_5A_ES1 1u
#define CYDEV_CHIP_REVISION_5A_PRODUCTION 1u
#define CYDEV_CHIP_REVISION_5B_ES0 0u
#define CYDEV_CHIP_REVISION_5B_PRODUCTION 0u
#define CYDEV_CHIP_REVISION_USED CYDEV_CHIP_REVISION_5B_PRODUCTION
#define CYDEV_CHIP_REV_EXPECT CYDEV_CHIP_REVISION_USED
#define CYDEV_CONFIG_FASTBOOT_ENABLED 1
#define CYDEV_CONFIG_UNUSED_IO_AllowButWarn 0
#define CYDEV_CONFIG_UNUSED_IO CYDEV_CONFIG_UNUSED_IO_AllowButWarn
#define CYDEV_CONFIG_UNUSED_IO_AllowWithInfo 1
#define CYDEV_CONFIG_UNUSED_IO_Disallowed 2
#define CYDEV_CONFIGURATION_COMPRESSED 1
#define CYDEV_CONFIGURATION_DMA 0
#define CYDEV_CONFIGURATION_ECC 1
#define CYDEV_CONFIGURATION_IMOENABLED CYDEV_CONFIG_FASTBOOT_ENABLED
#define CYDEV_CONFIGURATION_MODE_COMPRESSED 0
#define CYDEV_CONFIGURATION_MODE CYDEV_CONFIGURATION_MODE_COMPRESSED
#define CYDEV_CONFIGURATION_MODE_DMA 2
#define CYDEV_CONFIGURATION_MODE_UNCOMPRESSED 1
#define CYDEV_DEBUG_ENABLE_MASK 0x20u
#define CYDEV_DEBUG_ENABLE_REGISTER CYREG_MLOGIC_DEBUG
#define CYDEV_DEBUGGING_DPS_Disable 3
#define CYDEV_DEBUGGING_DPS_JTAG_4 1
#define CYDEV_DEBUGGING_DPS_JTAG_5 0
#define CYDEV_DEBUGGING_DPS_SWD 2
#define CYDEV_DEBUGGING_DPS_SWD_SWV 6
#define CYDEV_DEBUGGING_DPS CYDEV_DEBUGGING_DPS_SWD_SWV
#define CYDEV_DEBUGGING_ENABLE 1
#define CYDEV_DEBUGGING_XRES 0
#define CYDEV_DMA_CHANNELS_AVAILABLE 24u
#define CYDEV_ECC_ENABLE 0
#define CYDEV_HEAP_SIZE 0x1000
#define CYDEV_INSTRUCT_CACHE_ENABLED 1
#define CYDEV_INTR_RISING 0x00000000u
#define CYDEV_IS_EXPORTING_CODE 0
#define CYDEV_IS_IMPORTING_CODE 0
#define CYDEV_PROJ_TYPE 0
#define CYDEV_PROJ_TYPE_BOOTLOADER 1
#define CYDEV_PROJ_TYPE_LAUNCHER 5
#define CYDEV_PROJ_TYPE_LOADABLE 2
#define CYDEV_PROJ_TYPE_LOADABLEANDBOOTLOADER 4
#define CYDEV_PROJ_TYPE_MULTIAPPBOOTLOADER 3
#define CYDEV_PROJ_TYPE_STANDARD 0
#define CYDEV_PROTECTION_ENABLE 0
#define CYDEV_STACK_SIZE 0x4000
#define CYDEV_USE_BUNDLED_CMSIS 1
#define CYDEV_VARIABLE_VDDA 0
#define CYDEV_VDDA 5.0
#define CYDEV_VDDA_MV 5000
#define CYDEV_VDDD 5.0
#define CYDEV_VDDD_MV 5000
#define CYDEV_VDDIO0 5.0
#define CYDEV_VDDIO0_MV 5000
#define CYDEV_VDDIO1 5.0
#define CYDEV_VDDIO1_MV 5000
#define CYDEV_VDDIO2 5.0
#define CYDEV_VDDIO2_MV 5000
#define CYDEV_VDDIO3 5.0
#define CYDEV_VDDIO3_MV 5000
#define CYDEV_VIO0 5.0
#define CYDEV_VIO0_MV 5000
#define CYDEV_VIO1 5.0
#define CYDEV_VIO1_MV 5000
#define CYDEV_VIO2 5.0
#define CYDEV_VIO2_MV 5000
#define CYDEV_VIO3 5.0
#define CYDEV_VIO3_MV 5000
#define CYIPBLOCK_ARM_CM3_VERSION 0
#define CYIPBLOCK_P3_ANAIF_VERSION 0
#define CYIPBLOCK_P3_CAN_VERSION 0
#define CYIPBLOCK_P3_CAPSENSE_VERSION 0
#define CYIPBLOCK_P3_COMP_VERSION 0
#define CYIPBLOCK_P3_DECIMATOR_VERSION 0
#define CYIPBLOCK_P3_DFB_VERSION 0
#define CYIPBLOCK_P3_DMA_VERSION 0
#define CYIPBLOCK_P3_DRQ_VERSION 0
#define CYIPBLOCK_P3_DSM_VERSION 0
#define CYIPBLOCK_P3_EMIF_VERSION 0
#define CYIPBLOCK_P3_I2C_VERSION 0
#define CYIPBLOCK_P3_LCD_VERSION 0
#define CYIPBLOCK_P3_LPF_VERSION 0
#define CYIPBLOCK_P3_OPAMP_VERSION 0
#define CYIPBLOCK_P3_PM_VERSION 0
#define CYIPBLOCK_P3_SCCT_VERSION 0
#define CYIPBLOCK_P3_TIMER_VERSION 0
#define CYIPBLOCK_P3_USB_VERSION 0
#define CYIPBLOCK_P3_VIDAC_VERSION 0
#define CYIPBLOCK_P3_VREF_VERSION 0
#define CYIPBLOCK_S8_GPIO_VERSION 0
#define CYIPBLOCK_S8_IRQ_VERSION 0
#define CYIPBLOCK_S8_SAR_VERSION 0
#define CYIPBLOCK_S8_SIO_VERSION 0
#define CYIPBLOCK_S8_UDB_VERSION 0
#define DMA_CHANNELS_USED__MASK0 0x00000000u
#define CYDEV_BOOTLOADER_ENABLE 0

#endif /* INCLUDED_CYFITTER_H */
