qandrew/6.115-final-project/(commit log)

2016-04-26 psoc to r31jp files
    [RS232.sdf]
2016-04-27 vga connection from r31jp and psoc
    [RS232.sdf]
2016-04-27 added PSoC files contd
    [LAB2.sdf, PSOC to VGA.sdf]
2016-04-29 began april 28 lab notebook, temp commit bug free VGA display
    [PSOC to VGA.sdf]
2016-04-29 PSoC to R31JP implicit include function working
    [PSOC to VGA.sdf]
2016-04-29 can display HU on VGA
    [PSOC to VGA.sdf, Tic Tac Toe.sdf]
2016-04-29 tic tac toe board displays on VGA
2016-04-29 connected 8051 to PSoC via 8255 databus
    [Tic Tac Toe.sdf]
2016-05-05 random using 8254 timer, got 2 player implemented with p0 low/high cables
    [Tic Tac Toe.sdf]
2016-05-06 added capacitave chip interrupt code
2016-05-08 added laser cut board drawings
2016-05-09 3d tic tac toe playable without using 8051
    [Tic Tac Toe.sdf]
2016-05-11 changed cap_input.asm, now interrupts happen outside of ISR
2016-05-11 added cosmetic features to main.c software, hardware schematic in lab notebook
